CopperPilot/tablet/reviews/judge.md

# Independent judge

A separate agent compares the renders of the finished design with the reference photos, without seeing the design files or the other agents' notes.

**Overall 9/10** · form 9 · features 9 · requirements 9 (pass mark 7).

## Differences from the reference

- Enclosure depth is 9.4 mm (vs ~6.3 mm on the reference tablet) as explicitly specified to house the 3.2 mm Sharp LQ084R1SX01 display stackup and 3.8 mm battery allowance.
- The upper-right edge wall includes a flush rectangular plastic RF window insert over the Wi-Fi antenna as requested by the specification.
- The side-wall magnetic stylus charging strip and rear brand logo present in the reference photos are omitted per prompt and out-of-scope rules.

## Requirements

| Id | Verdict | Note |
|---|---|---|
| R1 | met | 134.0 x 198.0 x 9.4 mm CNC 6061-T6 aluminium unibody shell (10.4 mm at camera bump) with 14.0 mm corner radius, flush edge plastic RF window insert, and 0.5 mm thermal pad + graphite sheet to the SoC shield. |
| R2 | met | Rear view matches reference layout with 13.5 mm raised camera ring (+1.0 mm) at [14.8, 14.8] mm, 1.0 mm mic pinhole at [14.8, 24.6] mm over MK1, and 5.6 mm flash window at [14.8, 33.0] mm over D1 driven by AW3641EDNR U7, with no rear logo or plastic strip. |
| R3 | met | Sharp LQ084R1SX01 8.4-inch 1600x2560 panel connected via 40-pin dual-DSI FPC J1 (DSI0 + DSI1), TPS61165DRVR WLED boost U6 on mainboard, bonded cover-glass touch sensor on 10-pin FPC J2 (I2C + INT + RST) with U16 TMUX1112RSVR isolation and MPR121QR2 U9, and both bring-up risks recorded in decisions. |
| R4 | met | 28.0 x 125.0 x 0.8 mm 8-layer ENIG mainboard along the long edge with RK3566 U1 (C2943786), 4 GB LPDDR4X U2 at 13.5 mm spacing (<15 mm), 64 GB eMMC 5.1 U3, RK809-5/RK817 PMIC U4, RK860-0 (TCS4525-class) CPU buck U8, 4x M1.4 mounting holes, SH1/SH2 shield frames, and <=1.2 mm top / <=1.0 mm bottom component heights. |
| R5 | met | All 9 high-speed constraint groups (4 LPDDR4X byte lanes, LPDDR4X CA/CLK bus, MIPI-DSI0, MIPI-DSI1, MIPI-CSI cameras, and USB 2.0 OTG) are declared in electrical.high_speed with target impedances and length tolerances. |
| R6 | met | 25.0 x 12.0 mm USB-C daughterboard centred at the bottom edge with TYPE-C-31-M-12 J1, 5.075 kOhm effective CC1/CC2 pull-downs (R1/R2 = 6.8 kOhm // 20 kOhm sense path, within 5.1 kOhm +/- 10%), ESD protection on CC (D1/D2) and D+/D- (USBLC6-2P6 U1), active OVP/OCP eFuse U2, and 16-pin 0.5 mm FPC J2 to mainboard J6. |
| R7 | met | LP3698162-5600 1S 21.28 Wh Li-Po pouch battery with NTC and PCM fills ~76% of the main cavity alongside top/bottom stereo micro-speakers, front/rear MIPI-CSI camera modules, and the top-edge power/volume button flex assembly. |

## Features

| Id | Verdict | Note |
|---|---|---|
| F_DISPLAY | ok | 8.4-inch 113.04 x 180.86 mm active display window is centred on the front face inside a uniform ~10.5 mm bezel with rounded corners. |
| F_FRONT_CAM | ok | 3.0 mm circular front camera window is centred in the top front bezel at [67.0, 5.2] mm over the front MIPI-CSI camera module. |
| F_REAR_CAM | ok | 13.5 mm OD raised lens ring (~1.0 mm proud) with optical glass window sits at [14.8, 14.8] mm in the top-left corner of the rear view, matching the reference photo. |
| F_REAR_MIC | ok | 1.0 mm acoustic pinhole sits at [14.8, 24.6] mm on the rear camera vertical centreline and aligns directly with MEMS microphone MK1 in the actuators view. |
| F_REAR_FLASH | ok | 5.6 mm translucent LED flash diffuser window sits at [14.8, 33.0] mm on the rear camera centreline and aligns directly over white flash LED D1 in the actuators view. |
| F_USBC | ok | Bottom USB-C port cutout is centred on the bottom edge wall with the USB-C receptacle oval mouth and tongue facing straight out in the ports view. |
| F_BTN_PWR | ok | Top power button sits on the top edge above the camera corner and directly engages the button_flex switch strip in the actuators view. |
| F_BTN_VOL_UP | ok | Top-edge volume up button matches the reference tablet button placement and directly engages the button_flex switch strip in the actuators view. |
| F_BTN_VOL_DN | ok | Top-edge volume down button sits adjacent to volume up on the top edge and directly engages the button_flex switch strip in the actuators view. |
