CopperPilot/tablet/fab/usbc_board/compact-tablet-usbc_board-schematic.pdf

1 | 2 | 3 | 4 | 5 | 6 | 7 | 8
1 | 2 | 3 | 4 | 5 | 6 | 7 | 8

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
Size: A3 | Rev:
KiCad E.D.A. 10.0.4 | Id: 1/1 | F Date:

## Title: Compact 8.4-inch Android Tablet - USB-C Daughter Board

### File: compact-tablet-usbc_board.kicad_sch

### Sheet: /

1

1
2

2 R7

5.62k H2 MountingHole_Pad 1

1
2
2 D2 PTVS5V5D1BLYL | 1

1
2

2 C5

4.7nF 1

1
2

2 R1

6.8k | H1 MountingHole_Pad 1

1
2

2 R2

6.8k 1

1
2

2 C1

1uF 1

1
2

2 C2

100nF | 1

1
2

2 R10

1k | C

1

A 2 D4 BAS70L,315

1

1
2

2 R5

10k | 1

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
10 10
11 11
12 12
13 13
14 14
15 15

16 16 17 17 18 18

J2

0.5K-QX-16PWB

1

1
2

2 R6

34.8k EN/UVLO 1 | OVLO/OVCSEL 2 | PG/AUXOFF 3

FLT/PGTH 4

IN 5 | OUT | 6 DVDT | 7 GND

8

ILM

9

ITIMER

10 U2

TPS259470ARPWR

I/O1 1 GND 2

I/O2 3

I/O2 | 4
VBUS | 5
I/O1 | 6 U1 USBLC6-2P6

1

1
2

2 R8

9.09k 1

1
2
2 D1 PTVS5V5D1BLYL | 1

1
2

2 R4

10k

C

1

A 2 D5 PMEG3005EL,315

GND 1 | GND 2 | GND 3
VDD/IO | 4
VDD/IO | 5
VDD/IO | 6 EP

7 D3

ESTVS2200DRVR

1

1
2

2 R3

2.2R

1

1
2

2 C3

1uF | 1

1
2

2 C4

1uF 1

1
2

2 R9

1.37k

EH | 1
EH | 2
EH | 3
EH | 4 GND A1B12
VBUS A4B9CC1 A5 DP1 A6 DN1 A7

# SBU1 A8 GND B1A12VBUS B4A9CC2 B5 DP2 B6 DN2 B7

SBU2 B8
J1

TYPE-C-31-M-12

VBUS USB_CC1

VBUS_IN

USB_CC1_CONN | GND USB_CC1_CONN
VBUS_UVLO | VBUS_OVLO

USB_OTG0_DP USB_ESD_VBUS USB_OTG0_DM

GND

GND USB_CC1_CONN | VBUS

VBUS

VBUS

VBUS USB_OTG0_DM
USB_OTG0_DP

GND USB_OTG0_DP

VBUS_IN

USB_OTG0_DM

VBUS_IN

USB_CC2

VBUS_IN

GND

VBUS_ILM

VBUS | GND

VBUS

VBUS_IN

USB_ESD_BIAS

VBUS_DAMP | GND

GND

GND

GND

VBUS_DAMP | VBUS_OVLO

GND

VBUS_IN

VBUS GND

GND

GND

GND

GND

GND

VBUS_UVLO

VBUS | GND GND

GND

VBUS

VBUS_IN

VBUS_IN | GND USB_CC2_CONN

USB_CC2_CONN

VBUS_DVDT GND USB_CC1_CONN | GND

GND

VBUS_IN

USB_CC2_CONN

VBUS_DVDT GND USB_OTG0_DM

GND USB_OTG0_DP

GND

GND

GND

GND

VBUS_OVLO

VBUS_UVLO

USB_ESD_VBUS

VBUS_ILM

GND

GND

GND USB_CC2 USB_CC2_CONN

USB_OTG0_DM | GND USB_ESD_BIAS
USB_CC1 USB_OTG0_DP | USB_ESD_VBUS

ENGINEERING DESIGN NOTES (USB-C Daughterboard): 1. Active VBUS OVP/OCP Protection & Power-Tree Coordination (U2, TPS259470ARPWR): 28.3 mOhm back-to-back FET eFuse between VBUS_IN (J1) and VBUS (J2) routed with wide stitched F.Cu/B.Cu copper pours. Precision 1% divider R6 (34.8k) + R7 (5.62k) + R8 (9.09k) sets UVLO = 4.04V typ rising and OVLO = 6.54V typ rising (6.32V min..6.75V max) / 5.94V typ falling (5.77V min > 5.50V vSafe5V max). R9 (1.37k 1% on ILM) sets active OCP = 2.43A typ (2.19A min..2.68A max < 3.0A 6-pin J2 contact rating), while the system power budget

(2.4W typ / 6.0W peak = 1.20A @ 5V) and mainboard BQ25895 charger input limit (capped <= 2.00A via R8=200R 1.78A typ / 1.95A max hardware ILIM and <= 2.00A software IINLIM ceiling) stay strictly below U2 I_OL(min) = 2.19A. C5 (4.7 nF on DVDT Pin 7) sets dV/dt = 5.11 V/ms, while C4 (1 uF 25V) and Schottky diode D5 (PMEG3005EL_315) on VBUS decouple local output transients and clamp negative inductive kickback. 2. 22V Standoff Flat-Clamp VBUS_IN Surge TVS (D3, ESTVS2200DRVR C42400188): V_RWM = 22.0V, V_BR = 25.8V (> 20V USB-PD and > 6.75V U2 OVLO) and flat clamping V_CL = 27.6V typ / 28.6V max at 70A 8/20us (< 28.8V U2 abs max), allowing U2 to open-circuit sustained 6.5V-20V DC

overvoltages without D3 conducting DC current. Unswitched VBUS_IN capacitance C1 (1 uF 50V) + C3 (1 uF 50V via 0.33W 2.2R R3) = 2.0 uF (<= 2.2 uF). 3. Biased & Isolated USB 2.0 ESD Clamp (U1, USBLC6-2P6): U1 Pin 5 (USB_ESD_VBUS, decoupled by 100 nF 50V C2 to GND) is biased from protected VBUS

via 1 kOhm R10 (USB_ESD_BIAS) and 70V ultra-low-leakage blocking diode D4 (BAS70L_315) at ~4.7V DC. 4. Compensated 5.075 kOhm Effective CC1/CC2 Rd Termination: R1 and R2 are 6.8 kOhm 1% (0402WGF6801TCE C25917) on USB_CC1_CONN / USB_CC2_CONN

in parallel with 10 kOhm series isolation resistors R4/R5 + 10 kOhm mainboard SARADC shunt resistors R49/R50, yielding
Rd(eff) = 6.8 kOhm || (10 kOhm + 10 kOhm) = 5.075 kOhm (-0.5% from 5.10 kOhm nominal, well within USB Type-C 5.1 kOhm +/- 10%).
