CopperPilot/tablet/reference/README.md

# Reference

What the CopperPilot agents were given: the prompt in [prompt.md](prompt.md) and the photos below.

Reference photos of a commercial product, used here only for comparison. All rights belong to their owners; this project is not affiliated with or endorsed by the product's maker.

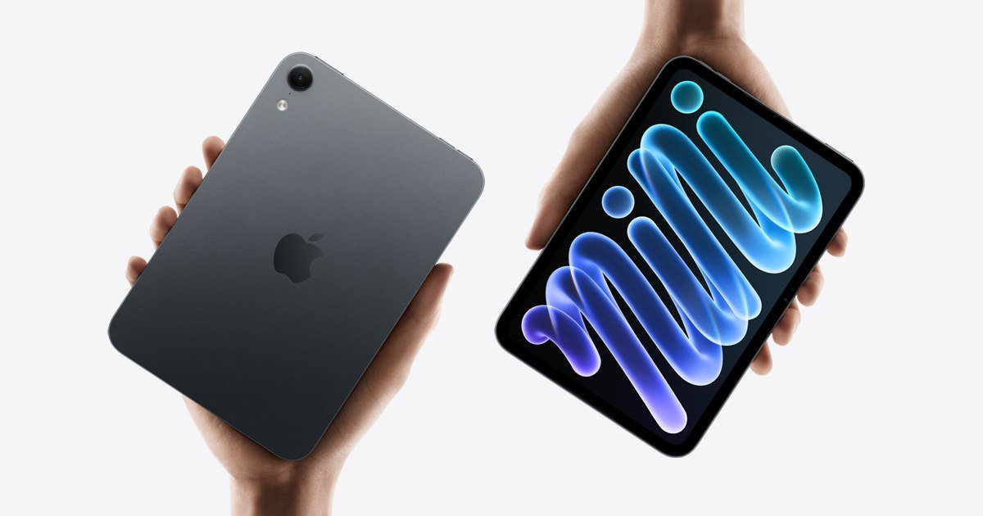
[picture p13: reference/photos/front_back.jpg]
front_back

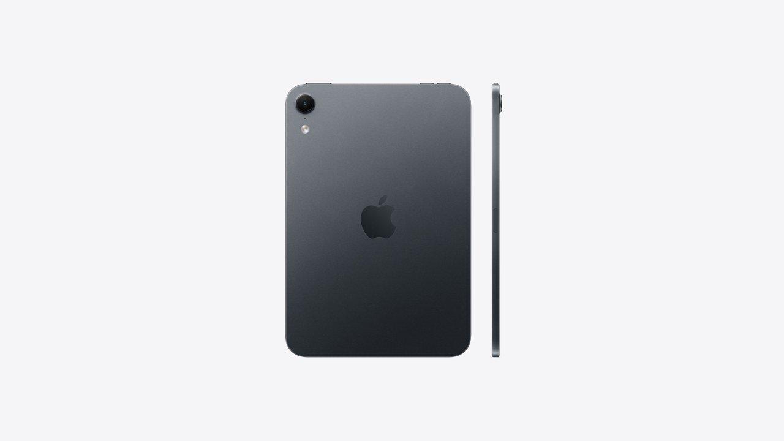
[picture p14: reference/photos/rear_side.jpg]
rear_side

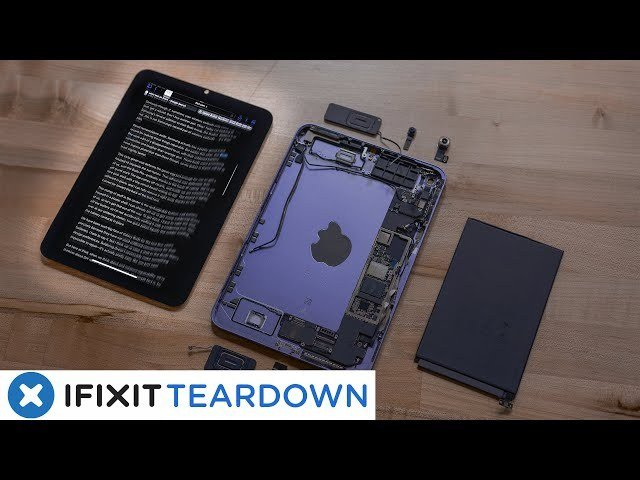
[picture p15: reference/photos/teardown.jpg]
teardown
