CopperPilot/tablet/docs/images/thumbnail.gif

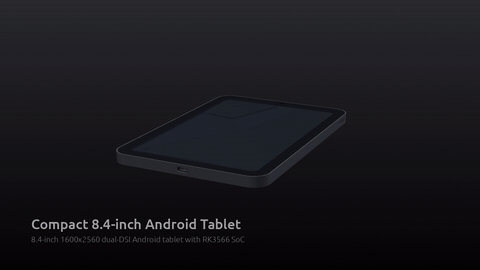
docs/images/thumbnail.gif
