CopperPilot/tablet/fab/mech/manifest.csv

part | files | process | material | finish | qty | bbox_mm | volume_cm3 | mass_g | service
back_shell | back_shell.stl back_shell.step | cnc | 6061-T6 aluminium | bead-blast + space-grey anodise | 1 | 134.0x198.0x10.4 | 32.27 | 87.1 | JLCCNC 3-axis milling
rf_window | rf_window.stl rf_window.step | cnc | PC/ABS RF-transparent plastic | matte dark grey | 1 | 1.1x16.0x3.4 | 0.05 | 0.1 | JLCCNC 3-axis milling
rear_camera_glass | rear_camera_glass.stl rear_camera_glass.step | cnc | tempered optical glass | AR-coated clear with dark mask | 1 | 11.1x11.1x1.0 | 0.10 | 0.1 | JLCCNC 3-axis milling
flash_window | flash_window.stl | sla | translucent optical polycarbonate | frosted diffuser | 1 | 5.1x11.3x1.0 | 0.02 | 0.0 | JLC3DP SLA resin
power_button | power_button.stl power_button.step | cnc | 6061-T6 aluminium | anodised | 1 | 13.6x2.1x3.8 | 0.09 | 0.2 | JLCCNC 3-axis milling
vol_up_button | vol_up_button.stl vol_up_button.step | cnc | 6061-T6 aluminium | anodised | 1 | 11.6x2.1x3.8 | 0.07 | 0.2 | JLCCNC 3-axis milling
vol_down_button | vol_down_button.stl vol_down_button.step | cnc | 6061-T6 aluminium | anodised | 1 | 11.6x2.1x3.8 | 0.07 | 0.2 | JLCCNC 3-axis milling
front_bezel | front_bezel.stl front_bezel.step | cnc | PC/ABS black bezel frame | matte black mask | 1 | 131.7x195.7x1.1 | 6.23 | 6.5 | JLCCNC 3-axis milling
cover_glass | cover_glass.stl cover_glass.step | cnc | chemically strengthened silicate glass | polished optical display cover glass | 1 | 112.9x176.9x1.1 | 21.92 | 26.3 | JLCCNC 3-axis milling
display_panel |  | purchased | LQ084R1SX01 |  | 1 | 117.0x191.2x3.2 |  |  | https://www.panelook.com/LQ084R1SX01_Sharp_8.4_LCM_parameter_23346.html
touch_sensor |  | purchased | TP-084-GG-10P |  | 1 | 116.0x186.0x0.3 |  |  | https://www.buydisplay.com/
battery |  | purchased | LP3698162-5600 |  | 1 | 98.0x162.0x3.6 |  |  | https://www.lipolbattery.com/
rear_camera |  | purchased | OV8858-AF-30P |  | 1 | 11.5x11.5x5.2 |  |  | https://www.arducam.com/
front_camera |  | purchased | OV5648-FF-24P |  | 1 | 8.0x8.0x3.8 |  |  | https://www.arducam.com/
top_speaker |  | purchased | SPK-1511-BOX-TOP |  | 1 | 24.0x9.0x3.0 |  |  | https://www.soberton.com/
bottom_speaker |  | purchased | SPK-1511-BOX-BOT |  | 1 | 24.0x9.0x3.0 |  |  | https://www.soberton.com/
button_flex |  | purchased | FPC-BTN-3SW-05P4 |  | 1 | 98.0x3.0x1.2 |  |  | https://www.molex.com/
