CopperPilot/tablet/fab/compact-tablet-bom.csv

Comment | Designator | Footprint | LCSC Part #
ANT3216A063R2400A | ANT1 | ANT-SMD_3P-L3.1-W1.6_ANT3216A063R2400A | C412135
10uF | C1,C2,C3,C4,C5,C6,C58,C63,C64,C70,C71,C82,C129,C130,C163,C165,C166,C167,C168,C178,C179,C180,C182 | C_0603_1608Metric | C19702
1uF | C7,C8,C9,C10,C11,C12,C29,C30,C31,C32,C33,C34,C36,C37,C38,C39,C40,C41,C43,C55,C59,C60,C62,C76,C77,C78,C79,C127,C128,C140,C142,C147,C148,C149,C151,C159,C160,C174,C177,C181,C183,C184 | C_0402_1005Metric | C52923
100nF | C13,C14,C15,C16,C17,C35,C42,C44,C45,C47,C48,C52,C56,C57,C61,C72,C75,C83,C84,C85,C86,C87,C88,C91,C92,C93,C94,C97,C98,C99,C100,C101,C105,C106,C107,C108,C109,C110,C111,C112,C113,C114,C115,C116,C117,C118,C119,C122,C123,C125,C126,C131,C132,C139,C141,C143,C144,C145,C146,C150,C152,C154,C156,C157,C158,C161,C162,C164,C169,C175,C176 | C_0402_1005Metric | C1525
22uF | C50,C51,C65,C80,C81,C89,C90,C95,C96,C102,C103,C104,C120,C121,C124 | C_0603_1608Metric | C59461
1nF | C53,C54,C73,C74,C133,C134,C135,C136,C137,C138 | C_0402_1005Metric | C1523
4.7uF | C28,C46,C153,C155 | C_0603_1608Metric | C19666
10uF | C170,C171,C172,C173 | C_0402_1005Metric | C77000
2.2uF | C18 | C_0402_1005Metric | C107369
1uF | C19 | C_0603_1608Metric | C15849
15pF | C20,C21,C22,C23,C24,C25 | C_0402_1005Metric | C1548
10uF | C26 | C_0603_1608Metric | C96446
47nF | C27 | C_0402_1005Metric | C272875
4.7uF | C49 | C_0402_1005Metric | C2858031
18pF | C66,C67 | C_0402_1005Metric | C1549
1.5pF | C68,C69 | C_0402_1005Metric | C1552
KW CELNM3.TK-S4S9-4L07M0-2686 | D1 | LED-SMD_3P-L1.9-W1.5_KW-CELMM1.TG | C17383700
PESD5V0F1BL,315 | D9,D10,D11,D12,D16,D19,D20,D21,D22,D23,D24,D25,D26,D27,D28,D32,D33,D34,D39,D40,D46,D47,D48 | SOD-882_L1.0-W0.6-BI | C45961
SMF7.5A | D13 | SOD-123F_L2.8-W1.8-LS3.7-RD | C123796
H36VND3B | D14 | SOD-323_L1.8-W1.3-LS2.7-BI | C20615816
PTVS5V5D1BLYL | D5,D6,D7,D8,D15,D17,D18,D29,D30,D31,D35,D36,D37,D38 | SOD-882_L1.0-W0.6-BI-1 | C553450
B16WS | D2 | D_SOD-323 | C364278
TPTVS0571P | D3 | DFN-2_L1.6-W1.0-P1.10-RD | C2844712
BAS70L,315 | D43,D44,D45,D49 | SOD-882_L1.0-W0.6-RD | C456141
BSMD0603L-300 | F1 | F0603 | C5374008
FPC-0.5HF-40PWBH10 | J1 | FPC-SMD_40P-P0.50_FPC-0.5HF-40PWBH10 | C5343289
0.5K-QX-10PWB | J2 | FPC-SMD_10P-P0.50_HDGC_0.5K-QX-10PWB | C2919478
0.5K-QX-30PWB | J3 | FPC-SMD_30P-P0.50_HDGC_0.5K-QX-30PWB | C2919487
FPC-0.5HF-24PWBH10 | J4 | FPC-SMD_24P-P0.50_XUNPU_FPC-0.5HF-24PWBH10 | C5343283
DF58-4P-1.2V(21) | J5 | CONN-SMD_4P-P1.20_DF58-4P-1.2V-21 | C20723302
0.5K-QX-16PWB | J6 | FPC-SMD_16P-P0.50_HDGC_0.5K-QX-16PWB | C2919481
0.5K-QX-4PWB | J7,J8,J9 | FPC-SMD_4P-P0.50_HDGC_0.5K-QX-4PWB | C2919475
470nH | L1,L2,L3,L4,L5 | IND-SMD_L2.0-W1.6_WPN2016X | C97009
0.47uH | L10 | IND-SMD_L2.0-W1.6_WPN2016X | C97009
2.2nH | L11 | IND-SMD_L1.0-W0.5_LQG15HN1N6B02D | C86061
1uH | L12 | IND-SMD_L2.0-W1.6_WPN2016X | C97016
120R@100MHz | L13,L14,L15,L16,L17 | L0603 | C14709
470nH | L6 | L_1008_2520Metric | C317620
10uH | L7 | L_1008_2520Metric | C37428
1uH | L8 | L_1008_2520Metric | C370610
2.2uH | L9 | IND-SMD_L2.0-W1.6_WPN2016X | C97005
MSM261DCB002 | MK1 | MIC-SMD_5P-L2.8-W1.9_MSM261DCB002 | C51928216
PPM6N20V10 | Q1 | DFN-6_L2.0-W2.0-P0.65-BL-EP-1 | C918800
RUM002N02T2L | Q2 | SOT-723_L1.2-W0.8-P0.40-LS1.2-BR | C250130
120R | R1 | R_0402_1005Metric | C25079
30k | R10,R21,R22,R35,R86,R87 | R_0402_1005Metric | C25776
10k | R4,R5,R11,R12,R27,R28,R29,R30,R31,R38,R40,R42,R43,R45,R49,R50,R51,R52,R57,R61,R64,R82,R83,R89 | R_0402_1005Metric | C25744
10mR | R13 | R_0603_1608Metric | C728437
75k | R14,R36 | R_0402_1005Metric | C25798
2.2k | R2,R3,R15,R16,R17,R18,R84,R85 | R_0402_1005Metric | C25879
240R | R19,R20 | R_0402_1005Metric | C25094
110k | R23 | R_0402_1005Metric | C25745
0.22R | R24 | R_0603_1608Metric | C858642
22R | R25,R46,R93,R95 | R_0402_1005Metric | C25092
100R | R32,R33,R53,R54,R55,R56,R58,R59,R60 | R_0402_1005Metric | C25076
47k | R34,R91,R92 | R_0402_1005Metric | C25792
200k | R37 | R_0402_1005Metric | C25764
63.4k | R39 | R_0402_1005Metric | C38606
49.9R | R41 | R_0402_1005Metric | C25120
12k | R44,R90 | R_0402_1005Metric | C25752
300k | R47 | R_0402_1005Metric | C25774
100k | R48,R68,R69,R70,R72,R73,R74,R75,R76,R77,R78,R80,R81,R88 | R_0402_1005Metric | C25741
3.3R | R6 | R_0402_1005Metric | C270612
4.7k | R62,R63,R79 | R_0402_1005Metric | C25900
1k | R65 | R_0402_1005Metric | C11702
1M | R7,R66,R71 | R_0402_1005Metric | C26083
0R | R67,R94 | R_0402_1005Metric | C17168
196R | R8 | R_0402_1005Metric | C270631
5.1k | R9 | R_0402_1005Metric | C25905
KH-PBJ-440808 | SH1,SH2 | CONN-SMD_3P-L4.4-W0.8_C9900042675 | C19631108
RK3566 | U1 | BGA-565_L15.5-W14.4-P0.40_RK3566_1 | C2943786
NS4150B | U10,U23 | MSOP-8_L3.0-W3.0-P0.65-LS5.0-BL | C189961
BQ25895RTWR | U11 | QFN-24_L4.0-W4.0-P0.50-TL-EP2.7 | C80200
TPS63802DLAR | U12 | VSON-10_L3.0-W2.0-P0.50-TL | C2845237
TLV62569ADRLR | U13 | SOT-563_L1.6-W1.2-P0.50-LS1.6-BL | C398367
TPS22919DCKR | U14 | SC-70-6_L2.2-W1.3-P0.65-LS2.1-BR | C2149796
TLV75533PDRVR | U15,U21,U24 | WSON-6_L2.0-W2.0-P0.65-TL-EP | C2861750
TMUX1112RSVR | U16 | UQFN-16_L2.6-W1.8-P0.40-BL | C1849384
SN74LV1T34DCKR | U17,U18,U19 | SC-70-5_L2.1-W1.3-P0.65-LS2.1-BR | C78541
K4FBE3D4HM-MGCJ | U2 | FBGA-200_L15.0-W10.0-BL_K4F6E3S4HM | C19188580
TLV70018DCKR | U20 | SC-70-5_L2.1-W1.3-P0.65-LS2.1-BR | C133796
TMUX1511RSVR | U22 | UTQFN-16_L2.6-W1.8-P0.40-BL | C2673275
LM66200DRLR | U25 | SOT-583-8_L2.1-W1.2-P0.50-LS1.6-BL | C3235556
FEMDNN064G-C9A61 | U3 | BGA-153_L13.0-W11.5-P0.50-TL_FORESEE_FEMDME | C49284704
RK809-5 | U4 | QFN-68_L7.0-W7.0-P0.35-BL-EP5.5 | C2939628
RTL8723DS-CG | U5 | WQFN-48_L6.0-W6.0-P0.40-BL-EP4.2 | C2762334
TPS61165DRVR | U6 | WSON-6_L2.0-W2.0-P0.65-TL-EP | C122568
AW3641EDNR | U7 | WDFN-10_L3.0-W3.0-P0.50-BL-EP | C164096
RK860-0 | U8 | WLCSP-20_L2.0-W1.6-R5-C4-P0.40-TL | C19188628
MPR121QR2 | U9 | QFN-20_L3.0-W3.0-P0.40-BL | C91322
24MHz | Y1,Y3 | Crystal_SMD_3225-4Pin_3.2x2.5mm | C70590
32.768kHz | Y2 | FC-135R_L3.2-W1.5 | C32346
