CopperPilot/tablet/fab/usbc_board/compact-tablet-usbc_board-bom.csv

Comment | Designator | Footprint | LCSC Part #
1uF | C1 | C0402 | C1518208
100nF | C2 | C0402 | C131394
1uF | C3 | C0603 | C15849
1uF | C4 | C0402 | C52923
4.7nF | C5 | C0402 | C1538
PTVS5V5D1BLYL | D1,D2 | SOD-882_L1.0-W0.6-BI-1 | C553450
ESTVS2200DRVR | D3 | DFN-6_L2.0-W2.0-P0.65-BL-EP1.6 | C42400188
BAS70L,315 | D4 | SOD-882_L1.0-W0.6-BI-1 | C456141
PMEG3005EL,315 | D5 | SOD-882_L1.0-W0.6-BI-1 | C282565
TYPE-C-31-M-12 | J1 | USB-C_SMD-TYPE-C-31-M-12_1 | C165948
0.5K-QX-16PWB | J2 | FPC-SMD_16P-P0.50_HDGC_0.5K-QX-16PWB | C2919481
6.8k | R1,R2 | R0402 | C25917
1k | R10 | R0402 | C11702
2.2R | R3 | R0603 | C445778
10k | R4,R5 | R0402 | C25744
34.8k | R6 | R0402 | C47493
5.62k | R7 | R0402 | C25909
9.09k | R8 | R0402 | C11549
1.37k | R9 | R0402 | C423239
USBLC6-2P6 | U1 | SOT-666-6_L1.6-W1.2-P0.50-LS1.6-BL | C2827693
TPS259470ARPWR | U2 | VQFN-10_L2.0-W2.0-P0.45-TL | C3662799
