CopperPilot/tablet/case/out/vol_up_button.stl

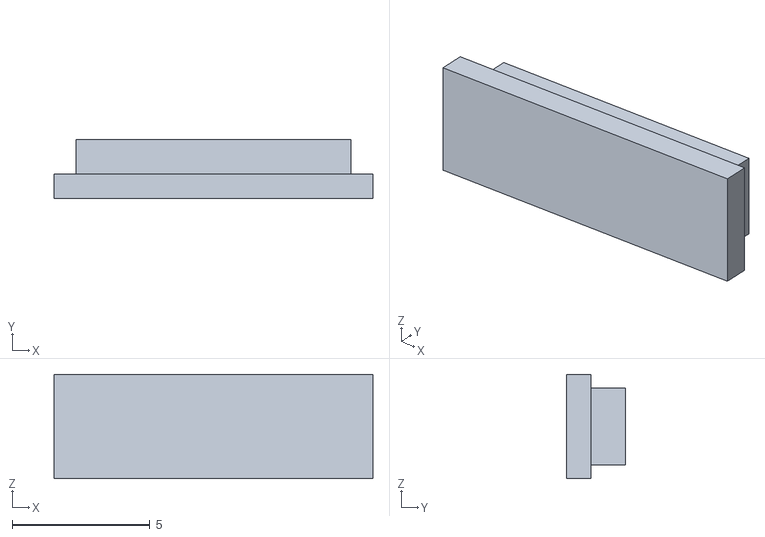
[picture p17: CAD file, 2026-11-06]
case/out/vol_up_button.stl
11.6 x 2.15 x 3.80
