CopperPilot/tablet/fab/mech/rf_window.step

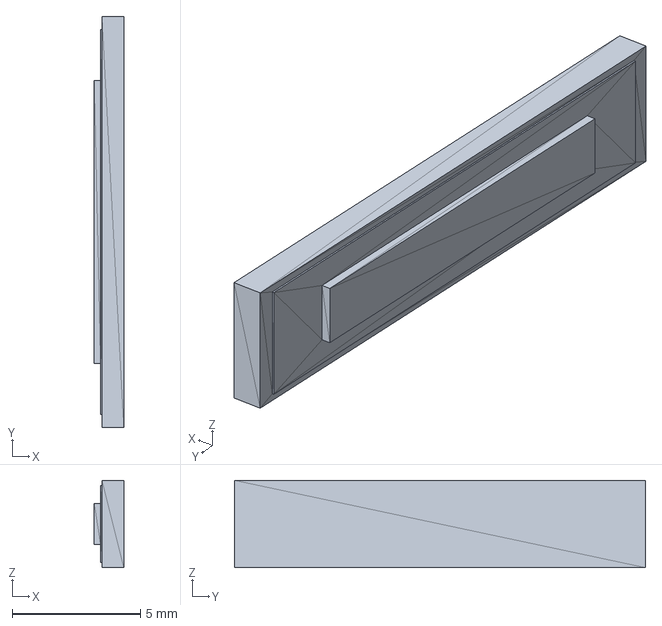
[picture p18: CAD file, 2026-11-06]
fab/mech/rf_window.step
1.15 x 16.0 x 3.40 mm
