CopperPilot/tablet/fab/usbc_board/compact-tablet-usbc_board.step

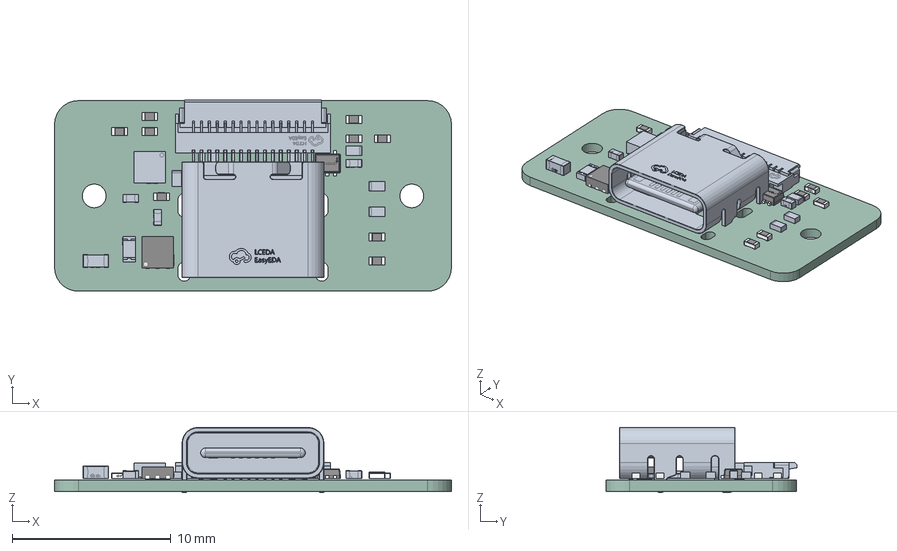
[picture p19: CAD file, 2026-11-06]
fab/usbc_board/compact-tablet-usbc_board.step
25.0 x 12.1 x 4.10 mm
R0402_L1.0-W0.5-H0.4 x 9
SOT-666-6P_L1.6-W1.2-H0.6-LS1.6-P0.50
DFN-6_L2.0-W2.0-P0.65-BL-EP1.6
compact-tablet-usbc_board_PCB
