CopperPilot/tablet/case/out/front_bezel.stl

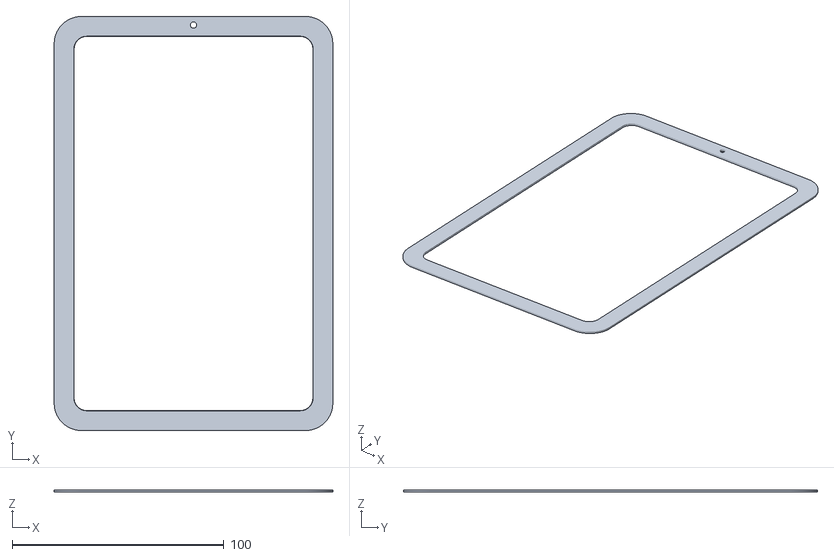
[picture p20: CAD file, 2026-11-06]
case/out/front_bezel.stl
131.7 x 195.7 x 1.10
