CopperPilot/tablet/fab/mech/power_button.step

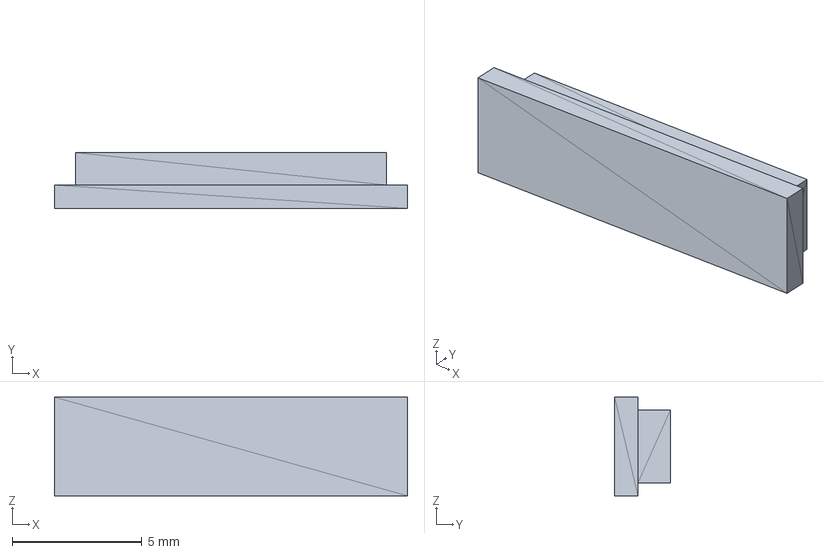
[picture p21: CAD file, 2026-11-06]
fab/mech/power_button.step
13.6 x 2.15 x 3.80 mm
