CopperPilot/tablet/case/out/back_shell.stl

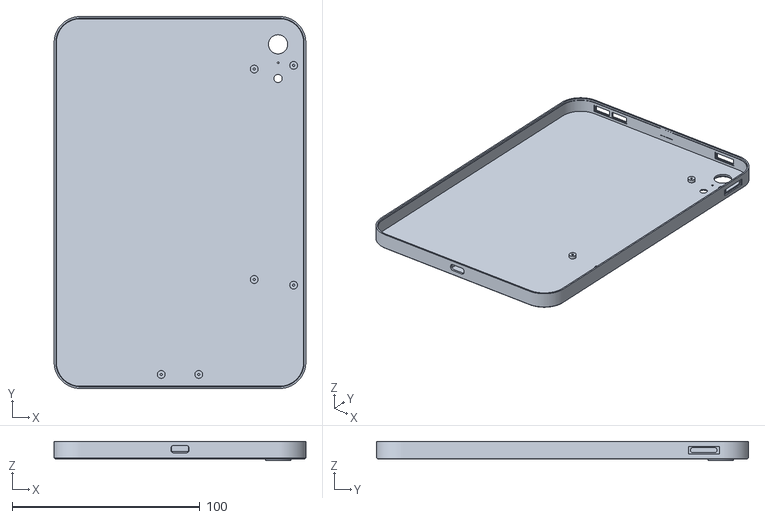
[picture p22: CAD file, 2026-11-06]
case/out/back_shell.stl
134.0 x 198.0 x 10.4
