CopperPilot/tablet/fab/mech/rear_camera_glass.step

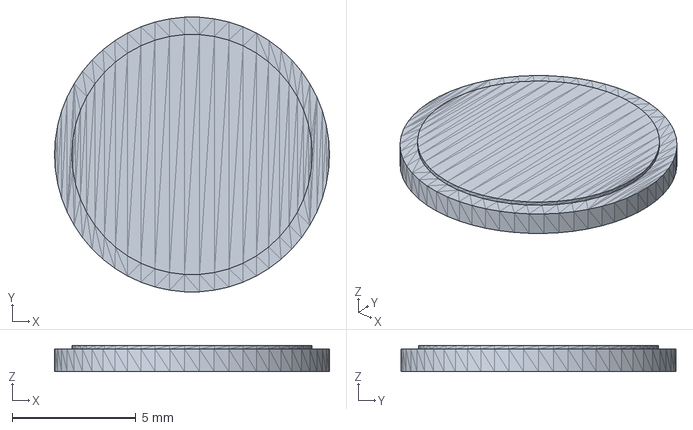
[picture p23: CAD file, 2026-11-06]
fab/mech/rear_camera_glass.step
11.1 x 11.1 x 1.05 mm
