CopperPilot/tablet/fab/mech/cover_glass.step

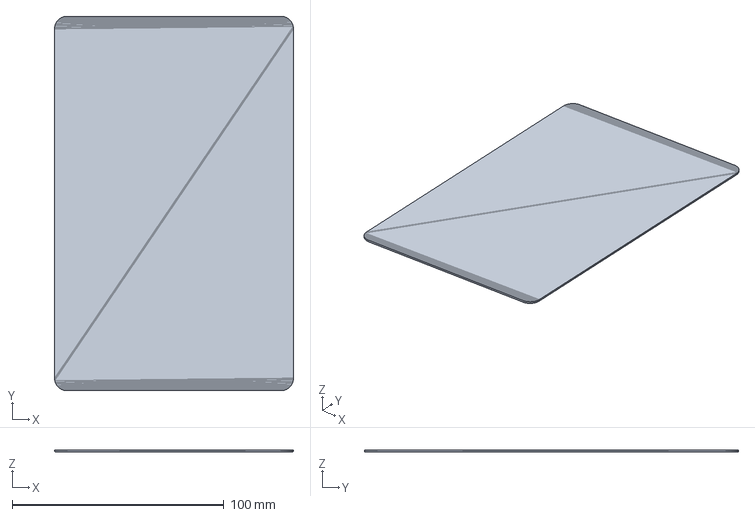
[picture p24: CAD file, 2026-11-06]
fab/mech/cover_glass.step
112.9 x 176.9 x 1.10 mm
