CopperPilot/tablet/fab/mech/flash_window.stl

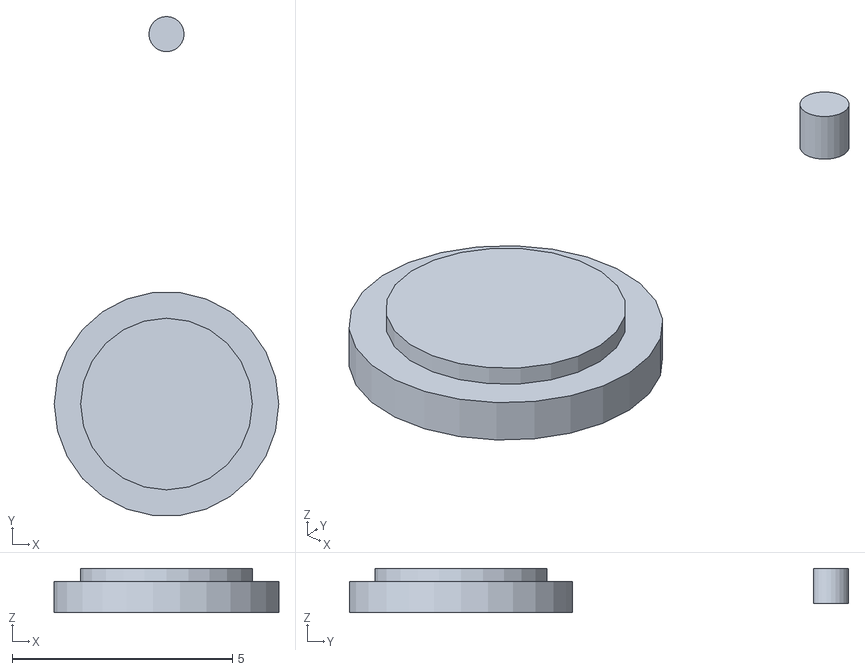
[picture p25: CAD file, 2026-11-06]
fab/mech/flash_window.stl
5.10 x 11.3 x 1.00
