CopperPilot/tablet/(list of files, cad)

Other CAD files:
fab/compact-tablet.step
case/out/rear_camera_glass.stl
case/out/vol_down_button.stl
fab/mech/back_shell.step
case/out/cover_glass.stl
case/out/rf_window.stl
fab/mech/front_bezel.step
fab/mech/vol_down_button.step
fab/mech/vol_up_button.step
case/purchased/battery.stl
case/purchased/bottom_speaker.stl
case/purchased/button_flex.stl
case/purchased/display_panel.stl
case/purchased/front_camera.stl
case/purchased/rear_camera.stl
case/purchased/top_speaker.stl
case/purchased/touch_sensor.stl
fab/mech/power_button.stl
