CopperPilot/tablet/fab/compact-tablet-schematic.pdf

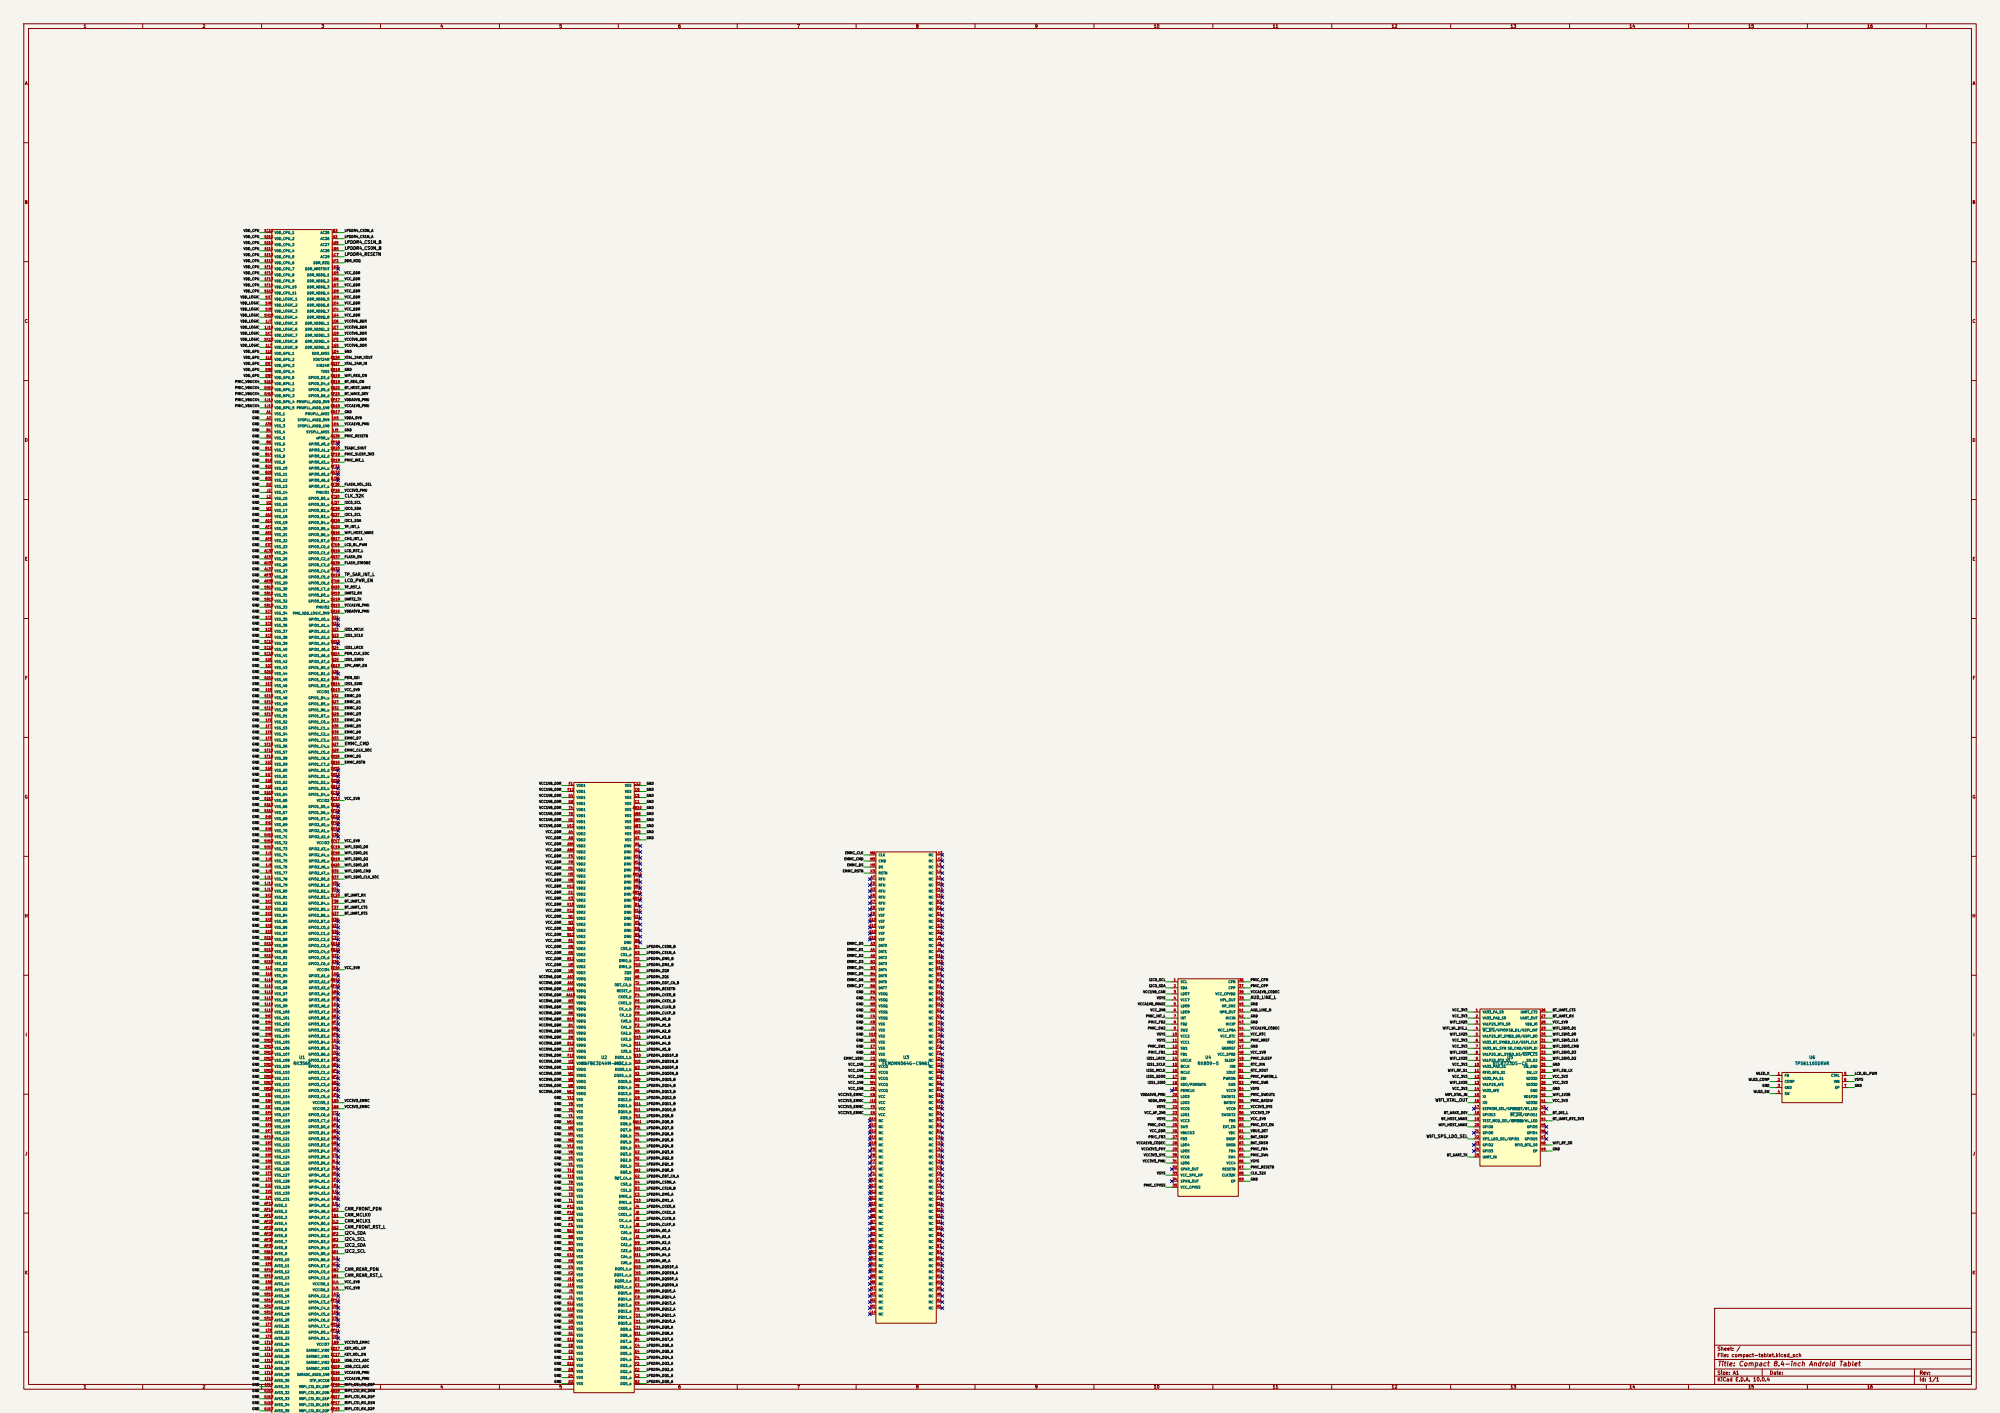
[picture p26: page 1]

File: compact-tablet.kicad_sch
Title: Compact 8.4-inch Android Tablet

Size: A1 | Rev:
KiCad E.D.A. 10.0.4 | Id: 1/1
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
