CopperPilot/tablet/hardware/usbc_board/compact-tablet-usbc_board.kicad_pcb

## KiCad design hardware/usbc_board/compact-tablet-usbc_board.kicad_pcb (2026-11-06)

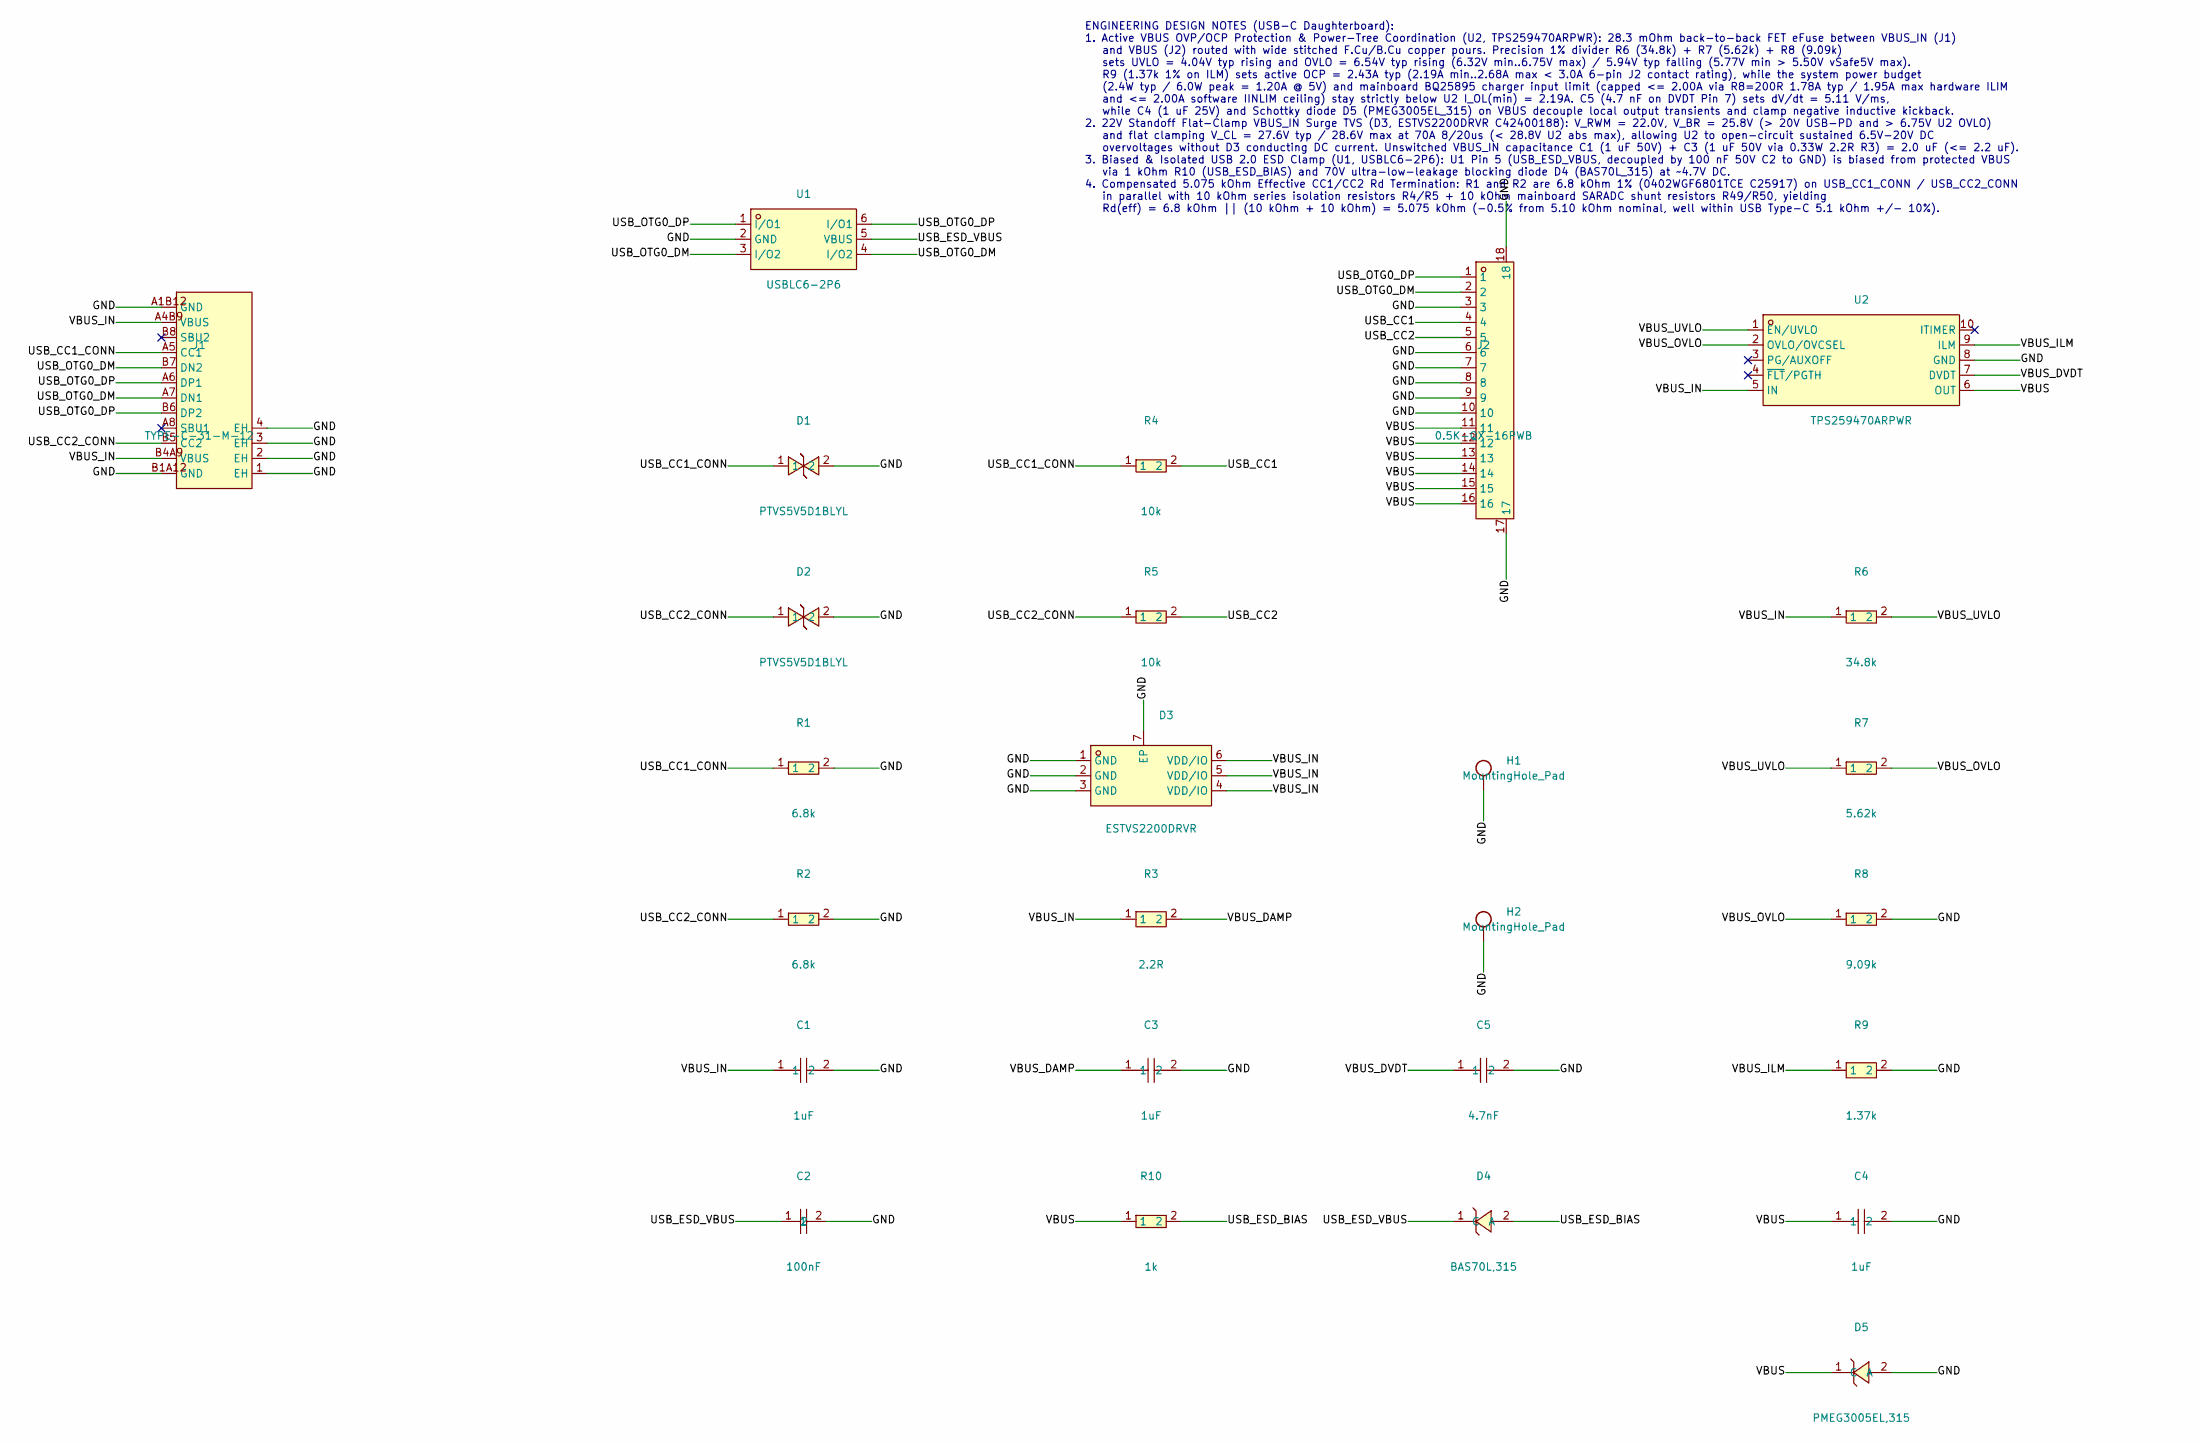
[picture p29: schematic compact-tablet-usbc_board.kicad_sch, Compact 8.4-inch Android Tablet - USB-C Daughter Board]

Parts:
C1: 1uF; C0402; MPN GRM155R61H105KE05D; LCSC C1518208
C2: 100nF; C0402; MPN CC0402KRX7R9BB104; LCSC C131394
C3: 1uF; C0603; MPN CL10A105KB8NNNC; LCSC C15849
C4: 1uF; C0402; MPN CL05A105KA5NQNC; LCSC C52923
C5: 4.7nF; C0402; MPN 0402B472K500NT; LCSC C1538
D1, D2: PTVS5V5D1BLYL; SOD-882_L1.0-W0.6-BI-1; MPN PTVS5V5D1BLYL; LCSC C553450
D3: ESTVS2200DRVR; DFN-6_L2.0-W2.0-P0.65-BL-EP1.6; MPN ESTVS2200DRVR; LCSC C42400188
D4: BAS70L,315; SOD-882_L1.0-W0.6-BI-1; MPN BAS70L,315; LCSC C456141
D5: PMEG3005EL,315; SOD-882_L1.0-W0.6-BI-1; MPN PMEG3005EL,315; LCSC C282565
H1, H2: MountingHole_Pad; MountingHole_1.5mm
J1: TYPE-C-31-M-12; USB-C_SMD-TYPE-C-31-M-12_1; MPN TYPE-C-31-M-12; LCSC C165948
J2: 0.5K-QX-16PWB; FPC-SMD_16P-P0.50_HDGC_0.5K-QX-16PWB; MPN 0.5K-QX-16PWB; LCSC C2919481
R1, R2: 6.8k; R0402; MPN 0402WGF6801TCE; LCSC C25917
R3: 2.2R; R0603; MPN ERJPA3J2R2V; LCSC C445778
R4, R5: 10k; R0402; MPN 0402WGF1002TCE; LCSC C25744
R6: 34.8k; R0402; MPN 0402WGF3482TCE; LCSC C47493
R7: 5.62k; R0402; MPN 0402WGF5621TCE; LCSC C25909
R8: 9.09k; R0402; MPN 0402WGF9091TCE; LCSC C11549
R9: 1.37k; R0402; MPN 0402WGF1371TCE; LCSC C423239
R10: 1k; R0402; MPN 0402WGF1001TCE; LCSC C11702
U1: USBLC6-2P6; SOT-666-6_L1.6-W1.2-P0.50-LS1.6-BL; MPN USBLC6-2P6; LCSC C2827693
U2: TPS259470ARPWR; VQFN-10_L2.0-W2.0-P0.45-TL; MPN TPS259470ARPWR; LCSC C3662799

Connections:
/GND: C1.2, C2.2, C3.2, C4.2, C5.2, D1.2, D2.2, D3.1 (GND), D3.2 (GND), D3.3 (GND), D3.7 (EP), D5.2 (A), H1.1, H2.1, J1.1 (EH), J1.2 (EH), J1.3 (EH), J1.4 (EH), J1.A1B12 (GND), J1.B1A12 (GND), J2.3, J2.6, J2.7, J2.8, J2.9, J2.10, J2.17, J2.18, R1.2, R2.2, R8.2, R9.2, U1.2 (GND), U2.8 (GND)
/USB_CC1: J2.4, R4.2
/USB_CC1_CONN: D1.1, J1.A5 (CC1), R1.1, R4.1
/USB_CC2: J2.5, R5.2
/USB_CC2_CONN: D2.1, J1.B5 (CC2), R2.1, R5.1
/USB_ESD_BIAS: D4.2 (A), R10.2
/USB_ESD_VBUS: C2.1, D4.1 (C), U1.5 (VBUS)
/USB_OTG0_DM: J1.A7 (DN1), J1.B7 (DN2), J2.2, U1.3 (I/O2), U1.4 (I/O2)
/USB_OTG0_DP: J1.A6 (DP1), J1.B6 (DP2), J2.1, U1.1 (I/O1), U1.6 (I/O1)
/VBUS: C4.1, D5.1 (C), J2.11, J2.12, J2.13, J2.14, J2.15, J2.16, R10.1, U2.6 (OUT)
/VBUS_DAMP: C3.1, R3.2
/VBUS_DVDT: C5.1, U2.7 (DVDT)
/VBUS_ILM: R9.1, U2.9 (ILM)
/VBUS_IN: C1.1, D3.4 (VDD/IO), D3.5 (VDD/IO), D3.6 (VDD/IO), J1.A4B9 (VBUS), J1.B4A9 (VBUS), R3.1, R6.1, U2.5 (IN)
/VBUS_OVLO: R7.2, R8.1, U2.2 (OVLO/OVCSEL)
/VBUS_UVLO: R6.2, R7.1, U2.1 (EN/UVLO)

Notes on the sheet:
ENGINEERING DESIGN NOTES (USB-C Daughterboard): 1. Active VBUS OVP/OCP Protection & Power-Tree Coordination (U2, TPS259470ARPWR): 28.3 mOhm back-to-back FET eFuse between VBUS_IN (J1) and VBUS (J2) routed with wide stitched F.Cu/B.Cu copper pours. Precision 1% divider R6 (34.8k) + R7 (5.62k) + R8 (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

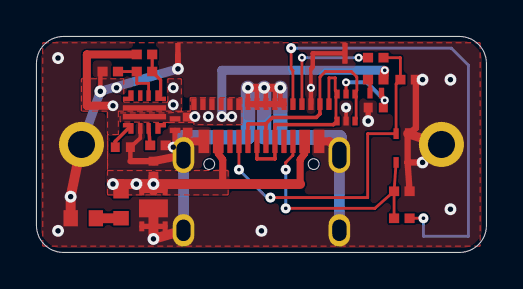
[picture p30: board compact-tablet-usbc_board.kicad_pcb from above]

Board: 2 copper layers, 25.0 x 12.0 mm, 26 parts (0 on the bottom side), 16 nets.
